TeglaTech/Pulse-sensor/Documentation/Graphics/populated.jpeg

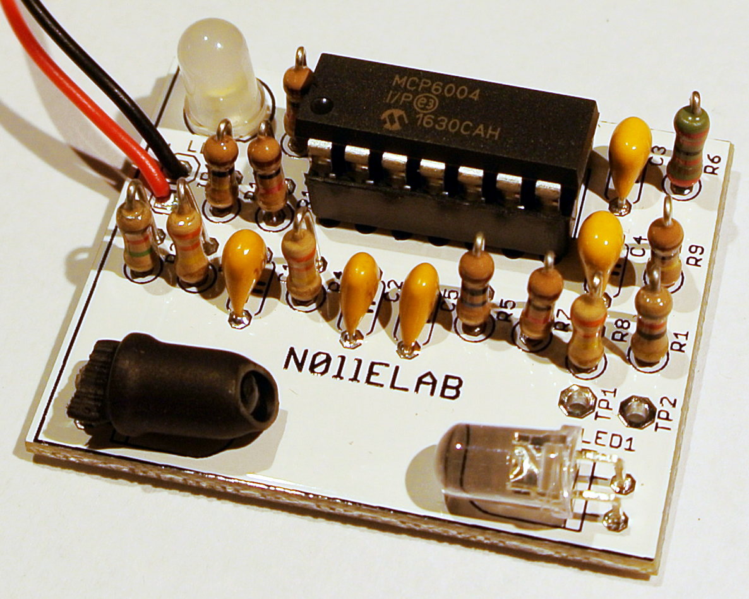
Documentation/Graphics/populated.jpeg
