TeglaTech/Pulse-sensor/README.md

# Pulse-sensor
Instructions and Eagle files for ELAB's DIY pulse sensor PCB.
