TeglaTech/Pulse-sensor/Documentation/Graphics/batterihållare.png

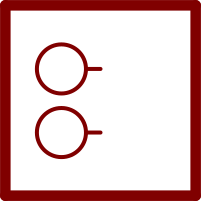
Documentation/Graphics/batterihållare.png
