TeglaTech/Pulse-sensor/Documentation/Graphics/fototransistor.png

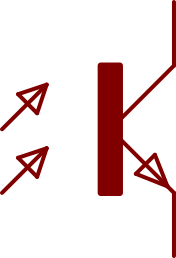
Documentation/Graphics/fototransistor.png
