TeglaTech/Pulse-sensor/Documentation/Graphics/lysdiod.png

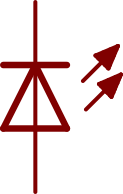
Documentation/Graphics/lysdiod.png
