TeglaTech/Pulse-sensor/Documentation/Graphics/schema.png

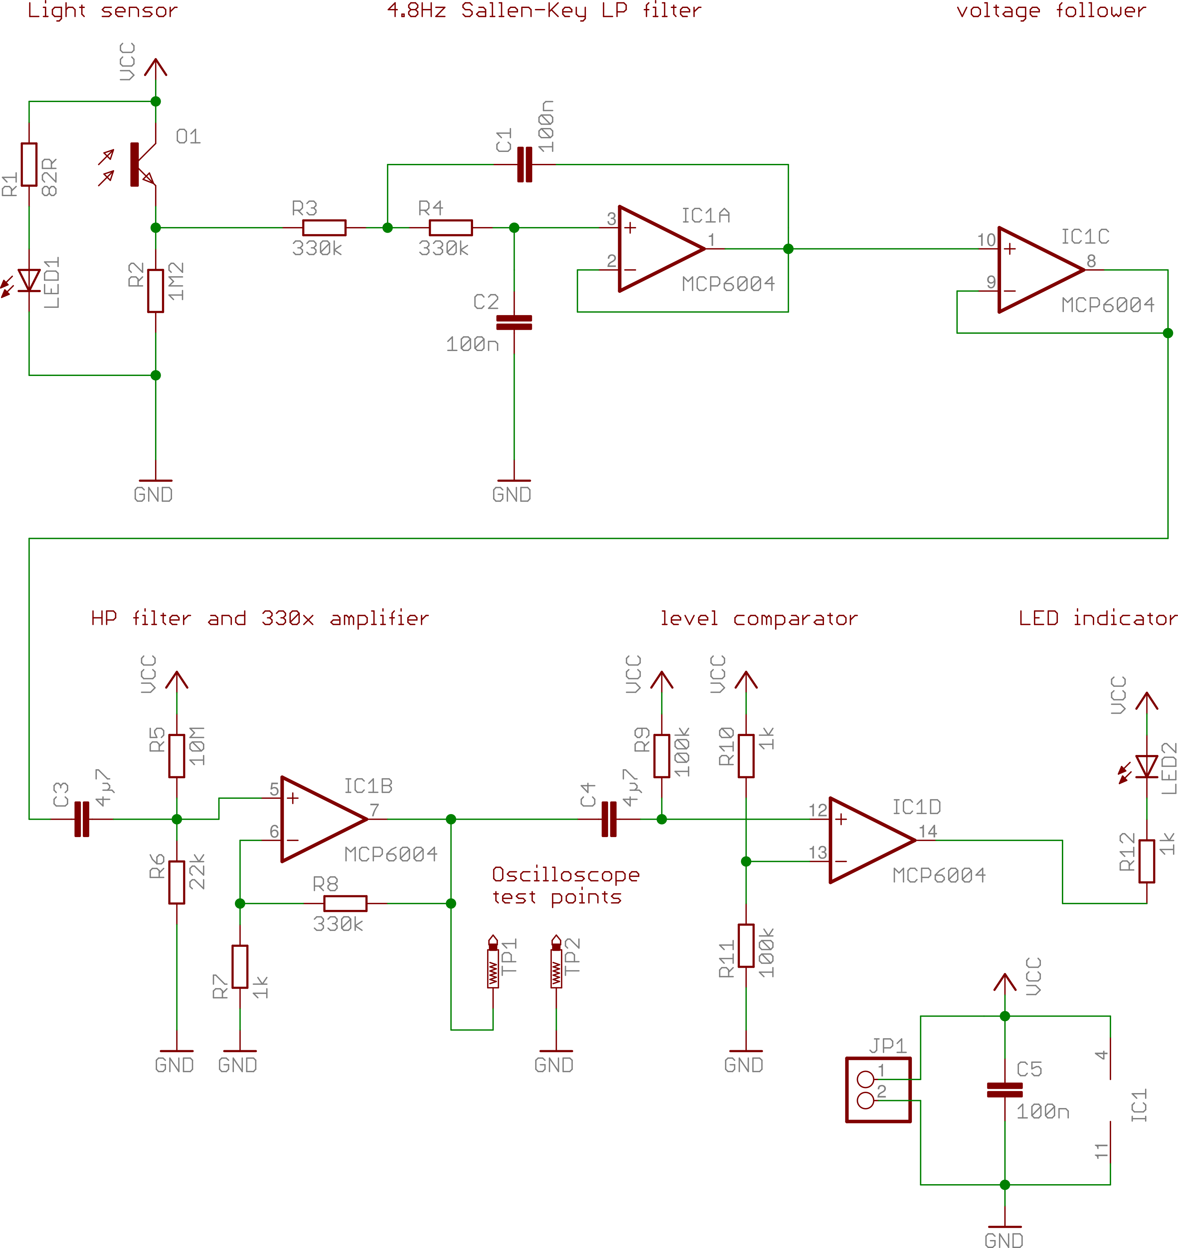
Documentation/Graphics/schema.png
