TeglaTech/Pulse-sensor/PCB design files/N0llELAB_final.brd

## EAGLE design PCB design files/N0llELAB_final.brd (2017-09-10)

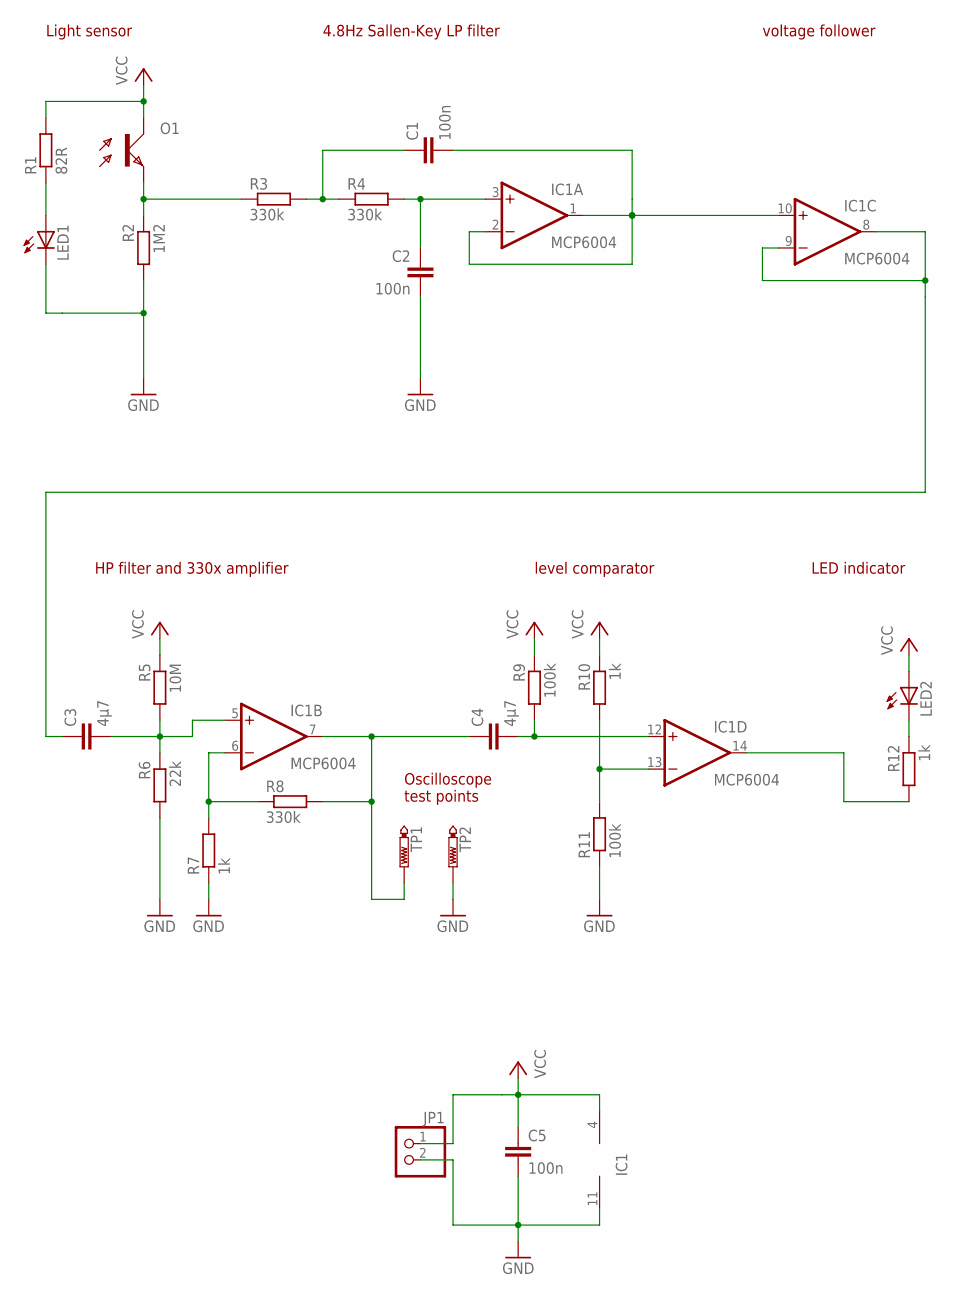
[picture p10: schematic N0llELAB_final.sch]

Parts:
C1, C2, C5: 100n; C050-024X044
C3, C4: 4µ7; C050-024X044
IC1: MCP6004; DIL14
JP1: PINHD-1X02_2.54-S; 1X02-S
LED1: LED5MM-90L
LED2: LED5MM
O1: OPTOTRANS5MM-90R; LED5MM-90R
R1: 82R; 0207/2V
R2: 1M2; 0207/2V
R3, R4, R8: 330k; 0207/2V
R5: 10M; 0207/2V
R6: 22k; 0207/2V
R7, R10, R12: 1k; 0207/2V
R9, R11: 100k; 0207/2V
TP1, TP2: PTR1PAD1-13; P1-13

Connections:
GND: C2.2, C5.2, IC1.11 (V-), JP1.2, LED1.K (C), R2.2, R6.2, R7.1, R11.1, TP2.1
unnamed: O1.A (E), R2.1, R3.1
unnamed: C2.1, IC1.3 (+IN), R4.2
unnamed: C1.1, R3.2, R4.1
unnamed: C4.2, IC1.12 (+IN), R9.2
unnamed: IC1.13 (-IN), R10.2, R11.2
unnamed: IC1.14 (OUT), R12.2
unnamed: LED2.K (C), R12.1
unnamed: LED1.A, R1.1
unnamed: C3.1, IC1.8 (OUT), IC1.9 (-IN)
unnamed: C1.2, IC1.1 (OUT), IC1.2 (-IN), IC1.10 (+IN)
unnamed: C3.2, IC1.5 (+IN), R5.2, R6.1
unnamed: IC1.6 (-IN), R7.2, R8.1
unnamed: C4.1, IC1.7 (OUT), R8.2, TP1.1
VCC: C5.1, IC1.4 (V+), JP1.1, LED2.A, O1.K (C), R1.2, R5.1, R9.1, R10.1

Notes on the sheet:
4.8Hz Sallen-Key LP filter
voltage follower
Light sensor
HP filter and 330x amplifier
level comparator
LED indicator
Oscilloscope test points
IC1

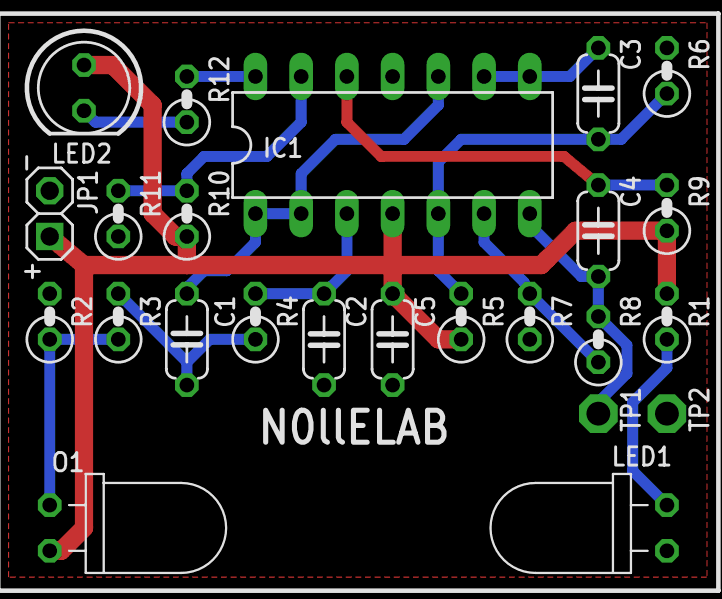
[picture p11: board N0llELAB_final.brd from above]

Board: 2 copper layers, 24 parts (0 on the bottom side), 15 nets.
