TeglaTech/Pulse-sensor/Documentation/Graphics/operationsförstärkare.png

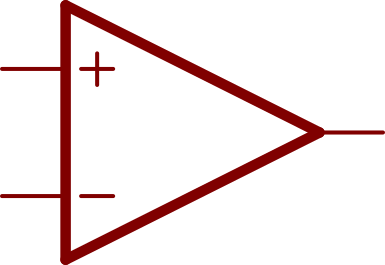
Documentation/Graphics/operationsförstärkare.png
